2GymnasioPeristeriou/smart-bin/README.md

# smart-bin
Το  έργο  μας περιλαμβάνει την κατασκευή ενός αυτόματου κάδου διαχωρισμού διαφορετικών απορριμμάτων χρησιμοποιώντας το Arduino. Επαγωγικοί, υπερηχητικοί αισθητήρες και αισθητήρες υγρασίας χρησιμοποιούνται για την ανίχνευση διαφορετικών απορριμμάτων. Όταν ένα συγκεκριμένο απόβλητο (ξηρό πλαστικό-χαρτί-γυαλί/ υγρό/μέταλλο) ανιχνεύεται στην υποδοχή του  κάδου, ένα ψηφιακό σήμα αποστέλλεται στην πλακέτα Arduino και κατά συνέπεια αποστέλλεται μια εντολή στον βηματικό κινητήρα- stepper motor από το Arduino για να περιστρέψει τη βάση στην οποία συνδέονται διαφορετικοί κάδοι για συγκεκριμένα απόβλητα. Ο σερβοκινητήρας χρησιμοποιείται για το άνοιγμα/κλείσιμο του πτερυγίου που είναι στερεωμένο στο κάτω μέρος της υποδοχής των απορριμμάτων του κάδου.                                    

Ηλεκτρονικός Εξοπλισμός

Arduino Uno Starter  kit 	105,51 € 	  
Stepper motor 28byj-48 and 5 Line 4 Phase Stepper Motor Drive Module driver 	2,5 € 4 €                  
Proximity sensor Επαγωγικός Αισθητήρας Απόστασης 8mm - LJ8A3-2-Z/BX	3,9€    
SparkFun Αισθητήρας Υγρασίας Εδάφους (με Κλέμα)	9,5€     
Ultrasonic sensor Αισθητήρας Υπερήχων2 - 450cm HY-SRF05	3,60 €              
Obstacle Avoidance IR Sensor Module	2€                         
Servo Micro 2.8kg.cm Metal Gears (Waveshare MG90S)	4,90 €                
7805 Voltage regulator 	0,50 €                               
Τροφοδοτικό 3V/4.5V/5/6/7.5V/9V/12VDC 1A - MWCL3K10GS	7,60€                    
Buzzer 5V - Passive	0,60€                                
Jumper Wires Male to male, female to male	4€

Σύνολο:148,61€
